berkecanbaz/jet-engine-control-panel/docs/pinout-diagram.pdf

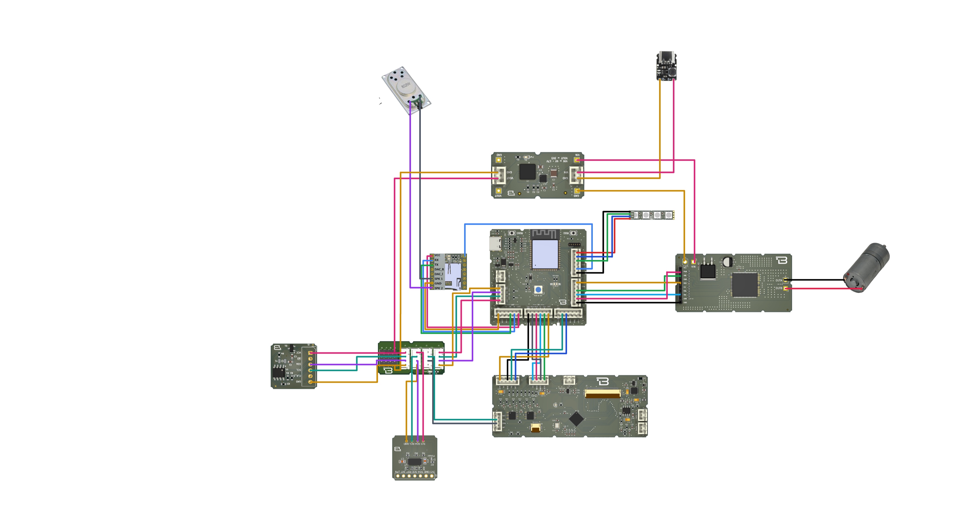
[picture p2: page 1]
